SeuMscGzy/Anticipatory-Active-Inference-for-Visual-Servo-of-UAV/vrpn_client_ros/Ros环境下安装vrpn-client.pdf

# Ros环境下安装vrpn-client

## Ros环境下安装vrpn-client

### 环境要求 安装步骤 1.拷贝文件至ros工作路径下解压 2.安装vrpn_client_ros 3.返回工作空间编译 4.编译完成后，需要更新.bash 5.运行代码 方式一 方式二 注意事项 6.查看接收到的数据 提示信息 异常情况 1.没有数据信息 示例代码 CPP 联系方式

# 环境要求

1.支持ROS Melodic Morenia以及 (http://wiki.ros.org/melodic/Installation)ROS Kinetic Kame（测试环境是Melodic。Kinetic之前的版本可 (http://wiki.ros.org/kinetic/Installation)

## 能不兼容）

# 安装步骤

# 1.拷贝文件至ros工作路径下解压

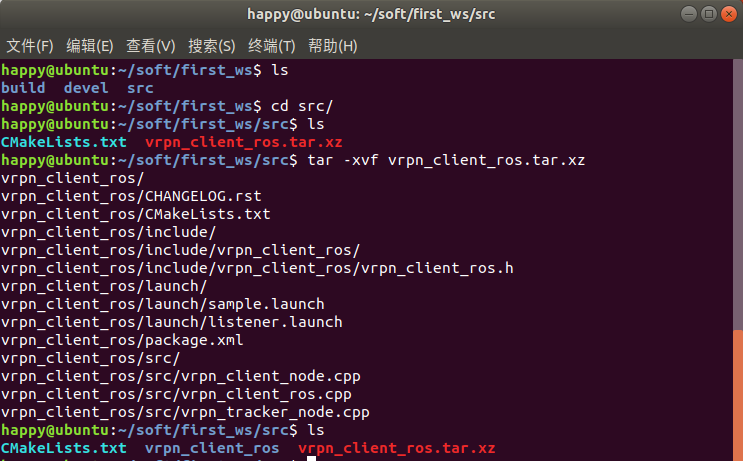
[picture p3: figure]

# 2.安装vrpn_client_ros

## kinetic下安装

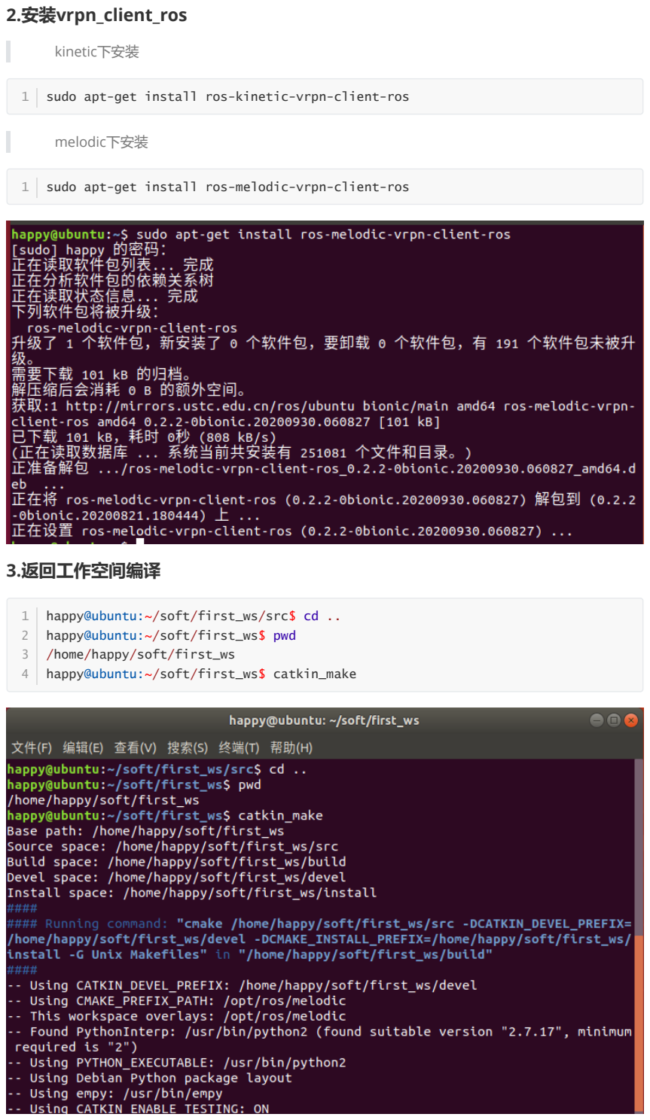
[picture p4: page 2]

## melodic下安装

# 3.返回工作空间编译

1 | sudo apt-get install ros-kinetic-vrpn-client-ros
1 | sudo apt-get install ros-melodic-vrpn-client-ros

happy@ubuntu:~/soft/first_ws/src$ cd .. happy@ubuntu:~/soft/first_ws$ pwd /home/happy/soft/first_ws
happy@ubuntu:~/soft/first_ws$ catkin_make

1
2
3
4

# 4.编译完成后，需要更新.bash

# 5.运行代码

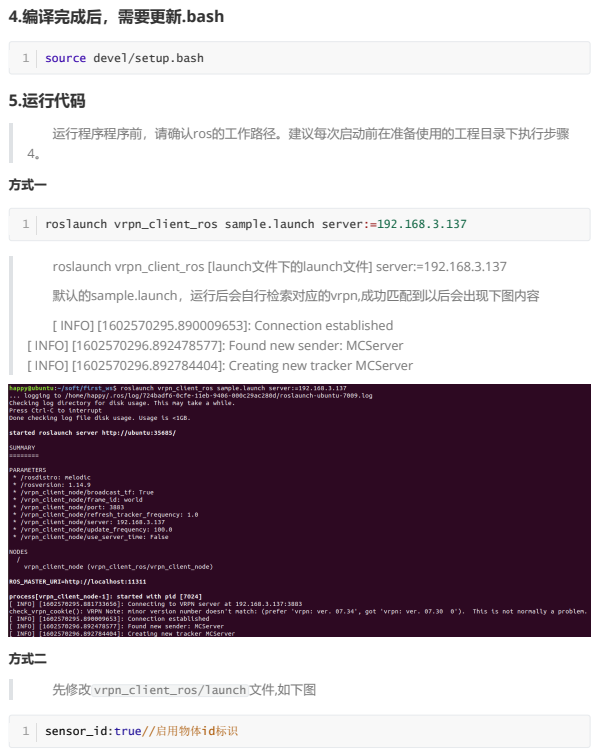
[picture p5: page 3]
运行程序程序前，请确认ros的工作路径。建议每次启动前在准备使用的工程目录下执行步骤; 方式一; 方式二; source devel/setup.bash; roslaunch vrpn_client_ros sample.launch server:=192.168.3.137; sensor_id:true//启用物体id标识

roslaunch vrpn_client_ros [launch文件下的launch文件] server:=192.168.3.137
默认的sample.launch，运行后会自行检索对应的vrpn,成功匹配到以后会出现下图内容
[ INFO] [1602570295.890009653]: Connection established
[ INFO] [1602570296.892478577]: Found new sender: MCServer
[ INFO] [1602570296.892784404]: Creating new tracker MCServer

先修改 vrpn_client_ros/launch 文件,如下图

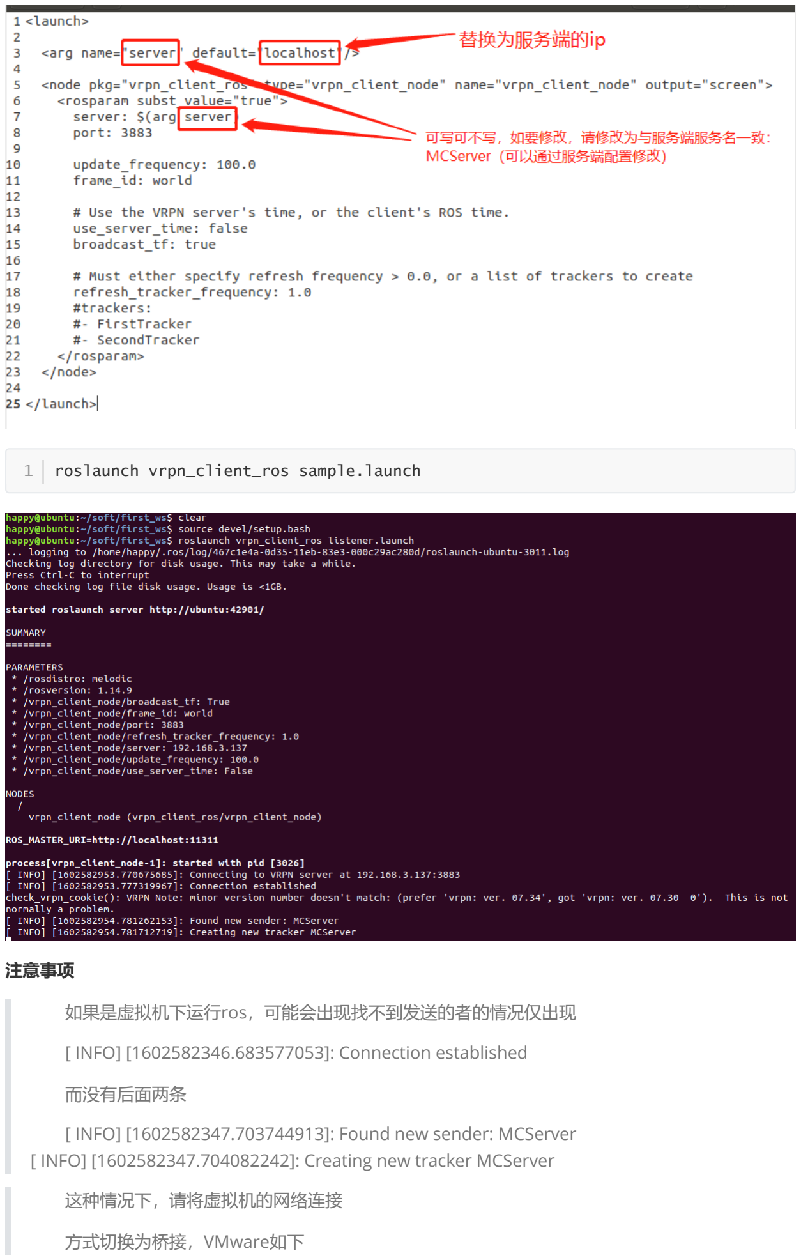
[picture p6: page 4]

## 注意事项

## 如果是虚拟机下运行ros，可能会出现找不到发送的者的情况仅出现

## [ INFO] [1602582346.683577053]: Connection established

## 而没有后面两条

## [ INFO] [1602582347.703744913]: Found new sender: MCServer [ INFO] [1602582347.704082242]: Creating new tracker MCServer

## 这种情况下，请将虚拟机的网络连接

## 方式切换为桥接，VMware如下

1 roslaunch vrpn_client_ros sample.launch

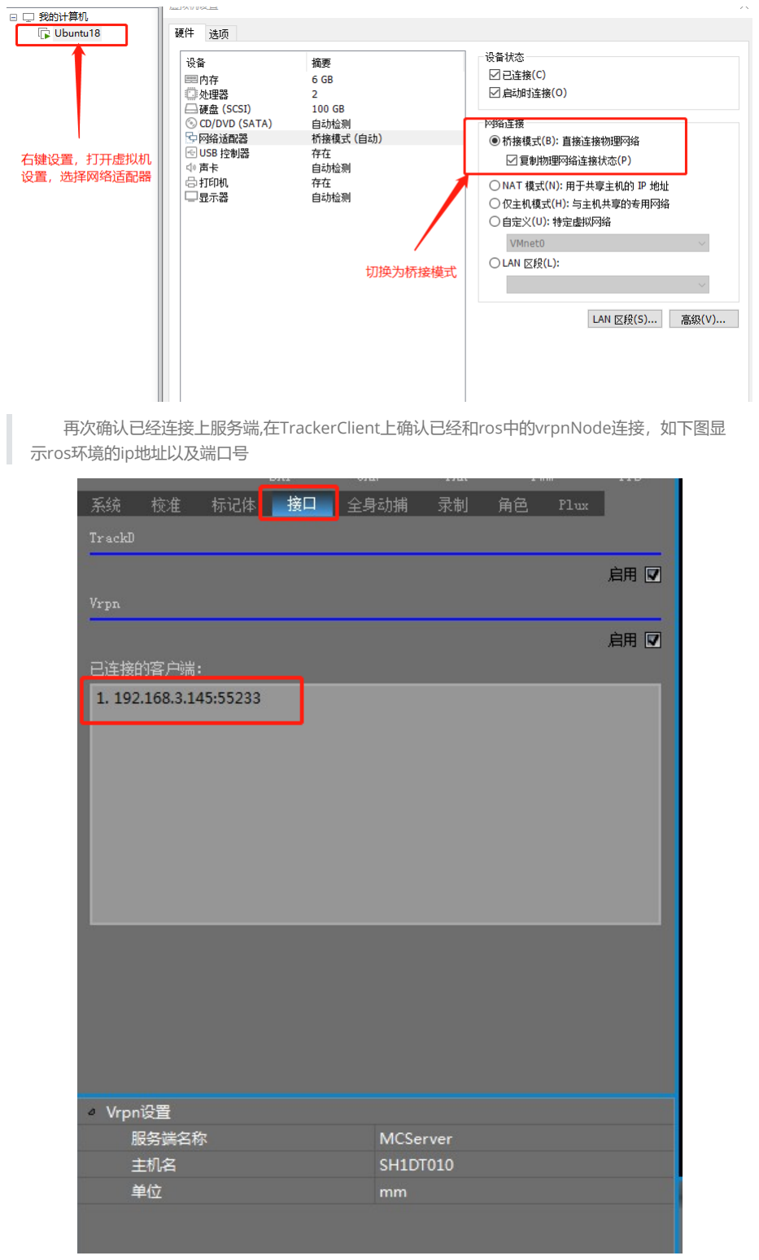
[picture p7: page 5]

## 再次确认已经连接上服务端,在TrackerClient上确认已经和ros中的vrpnNode连接，如下图显 示ros环境的ip地址以及端口号

# 6.查看接收到的数据

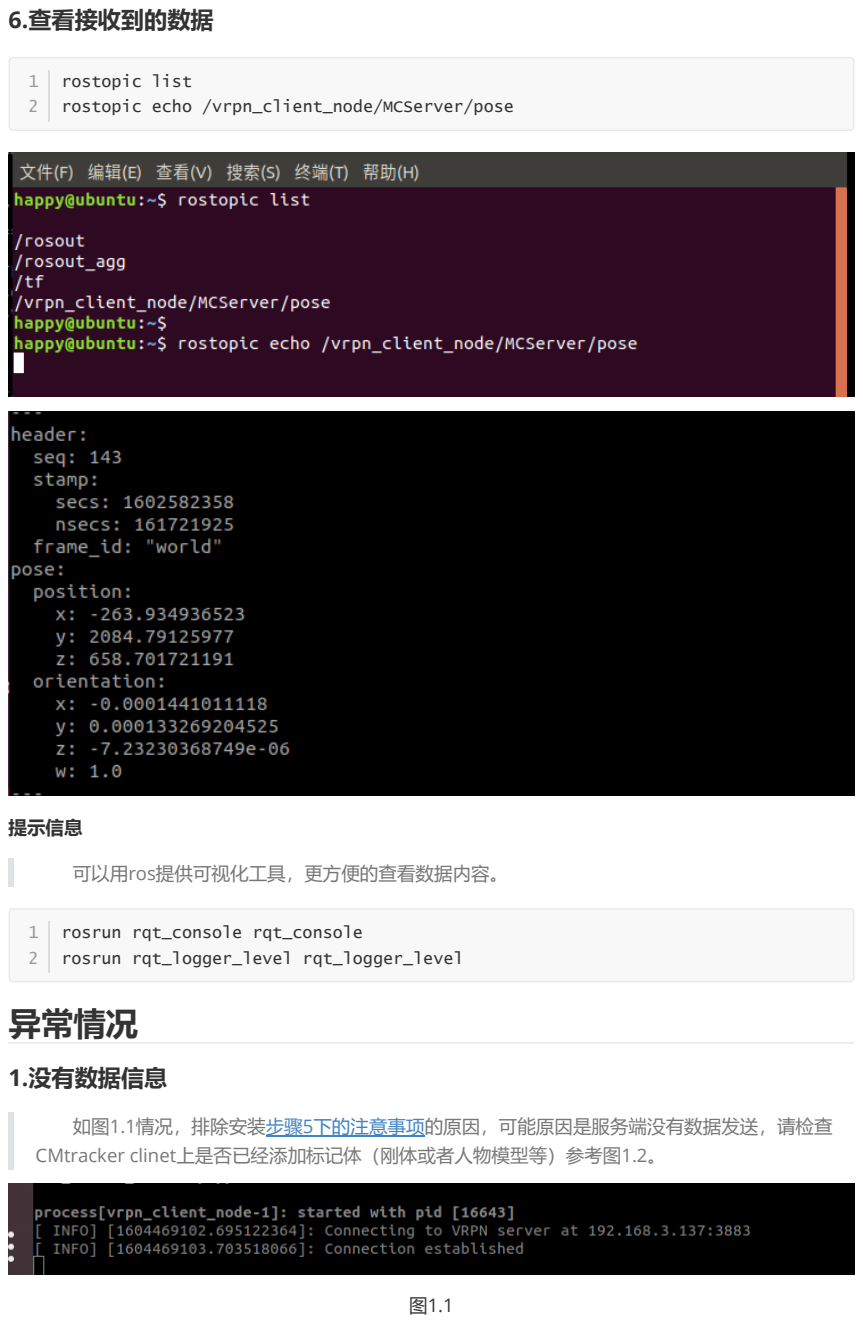
[picture p8: page 6]

图1.1

## 提示信息

## 可以用ros提供可视化工具，更方便的查看数据内容。

# 异常情况

# 1.没有数据信息

## 如图1.1情况，排除安装步骤5下的注意事项的原因，可能原因是服务端没有数据发送，请检查 CMtracker clinet上是否已经添加标记体（刚体或者人物模型等）参考图1.2。

rostopic list
rostopic echo /vrpn_client_node/MCServer/pose

1
2

rosrun rqt_console rqt_console
rosrun rqt_logger_level rqt_logger_level

1
2

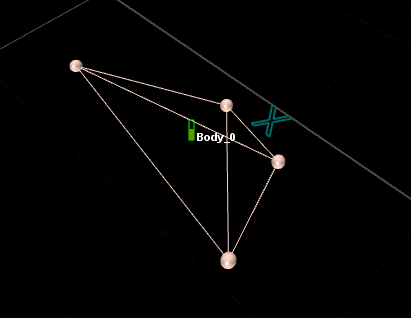
[picture p9: figure]

图1.2

# 示例代码

# CPP

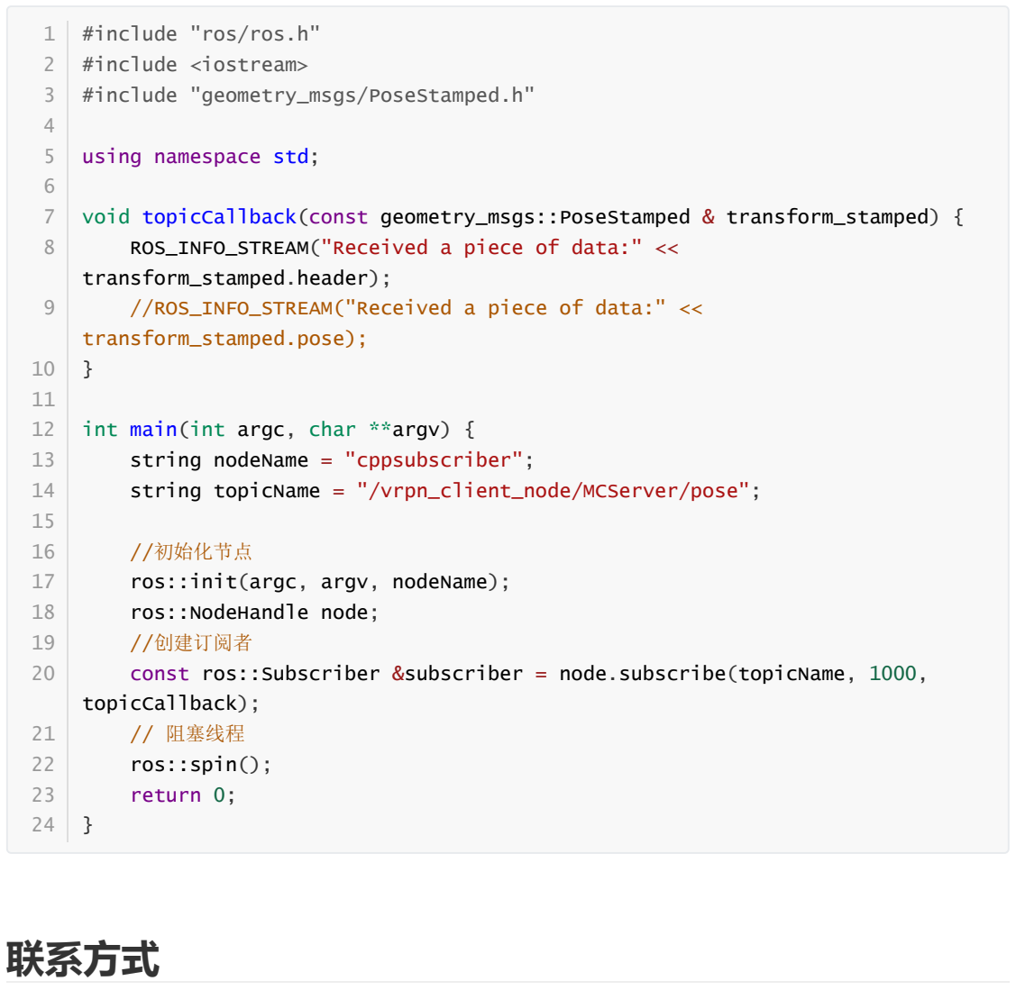
[picture p10: figure]
联系方式; #include "ros/ros.h"; #include <iostream>; #include "geometry_msgs/PoseStamped.h"; using namespace std;; transform_stamped.header);; transform_stamped.pose);; int main(int argc, char **argv) {; string nodeName = "cppsubscriber";; string topicName = "/vrpn_client_node/MCServer/pose";; //初始化节点; ros::init(argc, argv, nodeName);; ros::NodeHandle node; //创建订阅者; topicCallback); // 阻塞线程; ros::spin();; return 0;

void topicCallback(const geometry_msgs::PoseStamped & transform_stamped) { ROS_INFO_STREAM("Received a piece of data:" <<

//ROS_INFO_STREAM("Received a piece of data:" <<

const ros::Subscriber &subscriber = node.subscribe(topicName, 1000,

## 如果您安装的过程中遇到了其他疑问，欢迎致电青瞳视觉科技有限公司。

电话：021-56471565

## 技术支持：zhanghaidong@chingmu.com
