SeuMscGzy/Anticipatory-Active-Inference-for-Visual-Servo-of-UAV/platform_hardware/top plate.SLDPRT

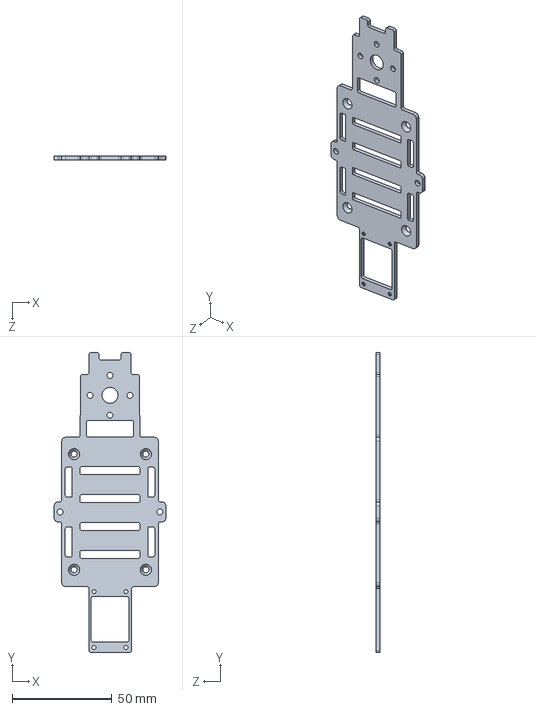
[picture p11: CAD file, 2026-01-14]
platform_hardware/top plate.SLDPRT
56.1 x 150.5 x 2.00 mm
