SeuMscGzy/Anticipatory-Active-Inference-for-Visual-Servo-of-UAV/platform_hardware/upboard for extra devices.SLDPRT

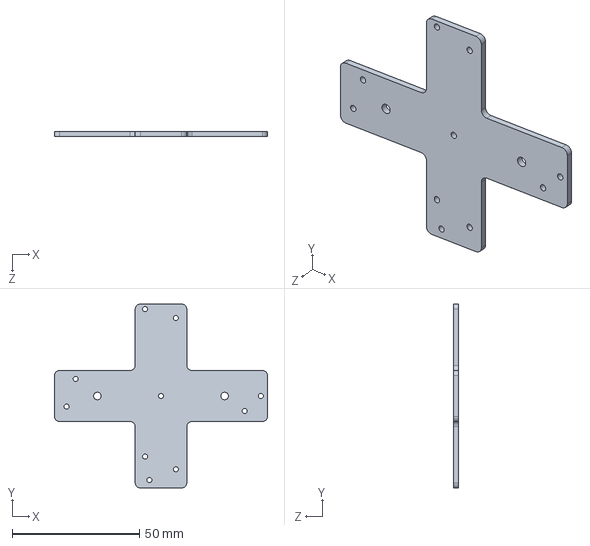
[picture p12: CAD file, 2026-01-14]
platform_hardware/upboard for extra devices.SLDPRT
83.7 x 72.3 x 2.00 mm
