SeuMscGzy/Anticipatory-Active-Inference-for-Visual-Servo-of-UAV/platform_hardware/baseborad.SLDPRT

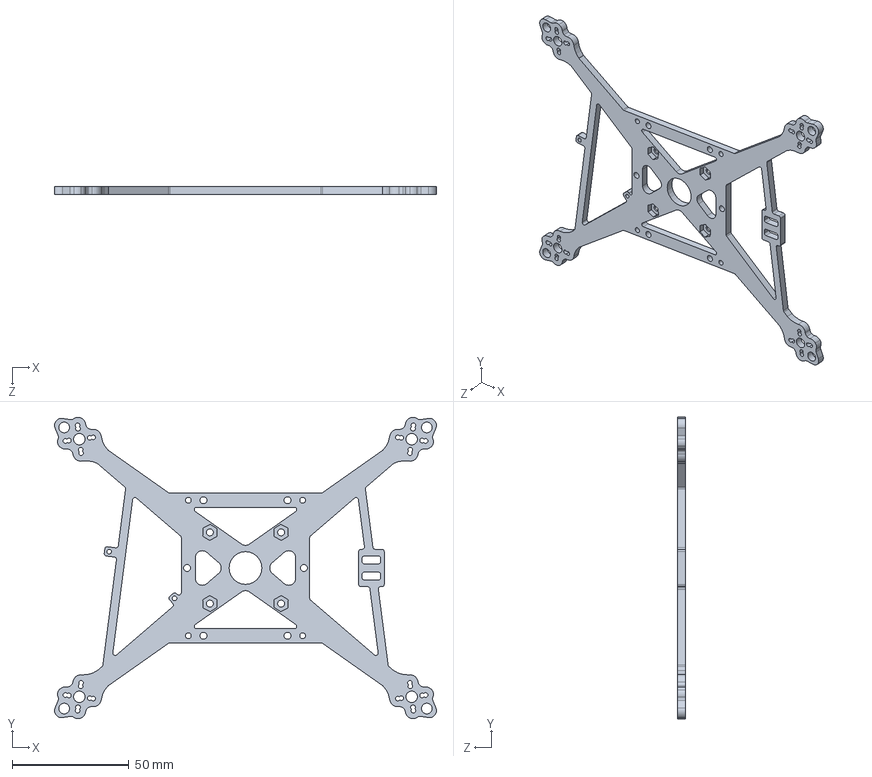
[picture p14: CAD file, 2026-01-14]
platform_hardware/baseborad.SLDPRT
163.5 x 129.1 x 3.50 mm
