SeuMscGzy/Anticipatory-Active-Inference-for-Visual-Servo-of-UAV/platform_hardware/tripod.SLDPRT

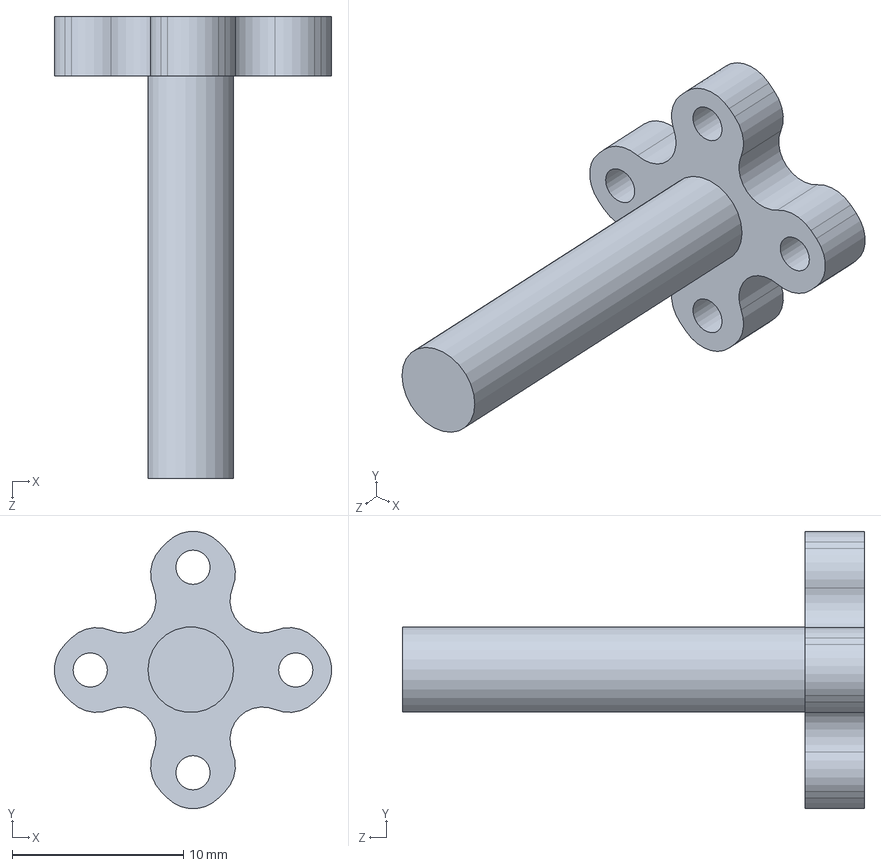
[picture p15: CAD file, 2026-01-14]
platform_hardware/tripod.SLDPRT
16.2 x 16.2 x 27.0 mm
