SeuMscGzy/Anticipatory-Active-Inference-for-Visual-Servo-of-UAV/transfer_aai_to_qp_problem.pdf

# Formulation of Prospective Active Inference as Quadratic Programming

## 1 Problem Statement

Consider the discrete-time Linear Time-Invariant (LTI) dynamical system model described by:

xk+1 = Axk + Buk + Fwk, | (1)
yk = Cxk + vk, | (2)

where xk ∈ R

n
represents the system state, uk ∈ R
m is the control input, and yk ∈ R | p is
the observation output.
In the active inference framework, we introduce a generative model to encapsulate the dynamics of the internal state. Let zk denote the internal state, which evolves according to the internal model:
zi+1|k = (A + BK)zi|k + wi|k, | (3)

where i denotes the prediction step index relative to the current time step k.

## 2 Future Variational Free Energy (F-VFE) Objective

At time step k, considering a prediction horizon N, we define the cumulative Variational Free Energy, denoted as Fk. This objective function is composed of two primary compo-nents: the external state error (deviation between the predicted system state x and the internal state z) and the internal dynamic consistency error:

Fk =

1
2

X

N

i=1

xi|k − zi|k

2

R˜
| | {z | }
State/Observation Error

+

1
2

X

N

i=1

zi|k − (A + BK)zi−1|k

2

Q˜
| | {z | }
| Internal Dynamics Consistency
. | (4)

## 3 Compact Matrix Formulation

To formulate the optimization problem as a standard Quadratic Program (QP), we define the lifted vectors over the horizon N:

Xk =

x1|k

xN|k

, Zk =

z1|k

zN|k

, Uk =

u0|k

uN−1|k

. | (5)

1

Based on the system dynamics (1), the predicted state trajectory Xk can be expressed as an affine function of the initial state and future control inputs:

| Xk = Fxk + ΦUk, | (6)

where F and Φ are the standard prediction matrices derived from (A, B).
To capture the internal state dynamics (3), we define the shift matrix S and the block-diagonal dynamics matrix M:
S = IN×N , | M = blockdiag(A + BK, . . . , A + BK). | (7)

The cost function (4) can then be rewritten in a compact quadratic form:

Fk =

1
2

∥Xk − Zk∥

| 2
| R˜ +
| 1
| 2

∥(S − M)Zk∥

| 2
| Q˜ . | (8)

## 4 Transformation to Standard QP Form

We define the joint optimization variable ξ(k) containing both control inputs and internal states:
ξ(k) = "
| Uk
| Zk
| . | (9)

We introduce transformation matrices T1 and T2 to express the error terms with respect to ξ(k):
| T1 =

h
| Φ −I

i
, T2 =

h
| 0 I

i
| . | (10)

Substituting Xk = Fxk + ΦUk into the cost function terms yields:

Xk − Zk = Fxk + ΦUk − Zk = Fxk + T1ξ(k), | (11)
(S − M)Zk = (S − M)T2ξ(k). | (12)

Expanding the cost function Fk(ξ), we obtain the standard quadratic form used for optimization:

| min
| ξ
| 1
| 2 ξ THξ + g T
| ξ, | (13)

where the Hessian matrix H and gradient vector g are given by:

H = T | T

1 RT˜
1 + T

T
2

(S − M)

TQ˜(S − M)T2, | (14)

g = T

T

1 R˜Fxk. | (15)

This formulation allows the Prospective Active Inference problem to be solved efficiently using standard QP solvers (e.g., qpOASES, OSQP), optimizing simultaneously for the control actions Uk and the internal state trajectory Zk.

2
