SeuMscGzy/Anticipatory-Active-Inference-for-Visual-Servo-of-UAV/Anticipatory_Active_Inference_with_Data_Augmentation/src/aai_qp.cpp

#include "aai_qp.h"

Optimizer::Optimizer(double dt, int Np, double precice_z1, double precice_z2,
                     double precice_w1, double precice_w2, double precice_z_u, double e1,
                     double umin, double umax)
    : dt(dt), Np(Np), precice_z1(precice_z1), precice_z2(precice_z2),
      precice_w1(precice_w1), precice_w2(precice_w2), precice_z_u(precice_z_u), e1(e1),
      umin(umin), umax(umax)
{
    // 离散系统矩阵
    MatrixXd Ad(6, 6);
    Ad << 1, 0, 0, dt, 0, 0,
        0, 1, 0, 0, dt, 0,
        0, 0, 1, 0, 0, dt,
        0, 0, 0, 1, 0, 0,
        0, 0, 0, 0, 1, 0,
        0, 0, 0, 0, 0, 1;
    MatrixXd Bd(6, 3);
    Bd << -0.5 * dt * dt, 0, 0,
        0, -0.5 * dt * dt, 0,
        0, 0, -0.5 * dt * dt,
        -dt, 0, 0,
        0, -dt, 0,
        0, 0, -dt;
    Eigen::MatrixXd K(6, 6);
    K << 0.8, 0, 0, 0, 0, 0,
        0, 0.8, 0, 0, 0, 0,
        0, 0, 0.8, 0, 0, 0,
        0, 0, 0, 0.15, 0, 0,
        0, 0, 0, 0, 0.15, 0,
        0, 0, 0, 0, 0, 0.15;
    Eigen::MatrixXd Closed_A = Ad - K;
    Eigen::VectorXd zr(6);
    zr << 0, 0, 0, 0, 0, 0;
    Eigen::VectorXd kr = K * zr;
    Eigen::VectorXd kr_temp = Eigen::VectorXd::Ones(Np);
    Eigen::MatrixXd kr_full = kroneckerProduct(kr_temp, kr);

    MatrixXd S_temp = MatrixXd::Zero(Np, Np + 1);
    for (int i = 0; i < Np; ++i)
    {
        S_temp(i, i + 1) = 1;
    }

    // Define 2x2 identity matrix I2
    MatrixXd I2 = MatrixXd::Identity(6, 6);

    // Compute Kronecker product S = S_temp ⊗ I2
    MatrixXd S = kroneckerProduct(S_temp, I2);

    // Define Np x (Np + 1) matrix M_temp
    MatrixXd M_temp = MatrixXd::Zero(Np, Np + 1);
    for (int i = 0; i < Np; ++i)
    {
        M_temp(i, i) = 1;
    }

    // Compute Kronecker product M = M_temp ⊗ Closed_A
    MatrixXd M = kroneckerProduct(M_temp, Closed_A);

    // Compute F
    Eigen::MatrixXd F = Eigen::MatrixXd::Identity(6, 6);
    Eigen::MatrixXd F_temp = Ad;
    for (int i = 1; i <= Np; ++i)
    {
        // Stack F_temp below F
        Eigen::MatrixXd F_new(F.rows() + F_temp.rows(), F.cols());
        F_new << F, F_temp;
        F = F_new;
        // Update F_temp to the next power of Ad
        F_temp = F_temp * Ad;
    }

    // Initialize Phi matrix
    Eigen::MatrixXd Phi((Np + 1) * 6, 3 * Np);
    Phi.setZero(); // Set all elements to zero
    // Construct Phi matrix
    for (int i = 2; i <= Np + 1; ++i)
    {
        for (int j = 1; j < i; ++j)
        {
            int power = i - j - 1;

            // Compute A to the power of 'power'
            Eigen::MatrixXd A_power = Eigen::MatrixXd::Identity(6, 6);
            for (int p = 0; p < power; ++p)
            {
                A_power *= Ad;
            }

            // Compute block = A_power * Bd
            Eigen::MatrixXd block = A_power * Bd;

            // Determine the position in Phi
            int row_start = (i - 1) * 6;
            int col_start = 3 * (j - 1);

            // Place block into Phi
            Phi.block(row_start, col_start, 6, 3) = block;
        }
    }

    // Compute T1 and T2
    Eigen::MatrixXd T11((6 * Np + 6), (6 * Np + 6));
    T11.setZero();
    // Fill T11 with identity matrices along the diagonal
    for (int i = 0; i <= Np; ++i)
    {
        T11.block(6 * i, 6 * i, 6, 6) = Eigen::MatrixXd::Identity(6, 6);
    }
    MatrixXd T1(Phi.rows(), Phi.cols() + T11.cols());
    T1 << Phi, -T11;

    // Initialize and construct T2
    Eigen::MatrixXd T2_temp1 = Eigen::MatrixXd::Zero(6 * (Np + 1), 3 * Np);
    Eigen::MatrixXd T2_temp2 = Eigen::MatrixXd::Identity(6 * (Np + 1), 6 * (Np + 1));
    Eigen::MatrixXd T2(T2_temp1.rows(), T2_temp1.cols() + T2_temp2.cols());
    T2 << T2_temp1, T2_temp2;

    // Initialize and construct T3
    Eigen::MatrixXd T3_temp1 = Eigen::MatrixXd::Identity(3 * Np, 3 * Np);
    Eigen::MatrixXd T3_temp2 = Eigen::MatrixXd::Zero(3 * Np, 6 * (Np + 1));
    Eigen::MatrixXd T3(T3_temp1.rows(), T3_temp1.cols() + T3_temp2.cols());
    T3 << T3_temp1, T3_temp2;

    // Compute BigB
    MatrixXd BigB = kroneckerProduct(MatrixXd::Identity(Np, Np), Bd);

    Eigen::MatrixXd R(6, 6);
    R.setZero();
    R(0, 0) = precice_z1;
    R(1, 1) = precice_z1;
    R(2, 2) = precice_z1;
    R(3, 3) = precice_z2;
    R(4, 4) = precice_z2;
    R(5, 5) = precice_z2;
    Eigen::MatrixXd C = Eigen::MatrixXd::Identity(6, 6);
    R = C.transpose() * R * C;

    // Initialize bigR matrix
    Eigen::MatrixXd bigR(6 * (Np + 1), 6 * (Np + 1));
    bigR.setZero();
    for (int i = 0; i <= Np; ++i)
    {
        bigR.block(6 * i, 6 * i, 6, 6) = R;
    }

    // Initialize Q matrix
    Eigen::MatrixXd Q(6, 6);
    Q.setZero();
    Q(0, 0) = precice_w1;
    Q(1, 1) = precice_w1;
    Q(2, 2) = precice_w1;
    Q(3, 3) = precice_w2;
    Q(4, 4) = precice_w2;
    Q(5, 5) = precice_w2;

    // Initialize bigQ matrix
    Eigen::MatrixXd bigQ(6 * Np, 6 * Np);
    bigQ.setZero();
    for (int i = 0; i < Np; ++i)
    {
        bigQ.block(6 * i, 6 * i, 6, 6) = Q;
    }

    Eigen::MatrixXd S_M = S - M;

    // Compute T4 = S_M * T2 - BigB * T3
    MatrixXd T4 = S_M * T2 - BigB * T3;

    // Compute bigMatrix1 = T1' * bigR * T1 + T4' * bigQ * T4
    bigMatrix1 = T1.transpose() * bigR * T1 + T4.transpose() * bigQ * T4;

    // Define M13 = zeros(Np + 2 * (Np + 1), Np + 2 * (Np + 1))
    MatrixXd M13 = MatrixXd::Zero(3 * Np + 6 * (Np + 1), 3 * Np + 6 * (Np + 1));

    // Set M13(0:Np - 1, 0:Np - 1) = Identity matrix
    M13.block(0, 0, 3 * Np, 3 * Np) = MatrixXd::Identity(3 * Np, 3 * Np);

    // Update bigMatrix1
    bigMatrix1 += M13 * precice_z_u;
    cout << bigMatrix1 << endl;
    /*// Compute eigenvalues of bigMatrix1
    SelfAdjointEigenSolver<MatrixXd> eigensolver(bigMatrix1);
    if (eigensolver.info() != Success)
    {
        std::cerr << "Eigenvalue computation did not converge." << std::endl;
    }
    VectorXd eigenvalues = eigensolver.eigenvalues();*/

    bigMatrix2 = F.transpose() * bigR * T1;

    // Compute bigMatrix3 = -kr' * bigQ * T4
    bigMatrix3 = -kr_full.transpose() * bigQ * T4;
    //cout << bigMatrix3 << endl;
    /*
    // 构建矩阵 M1 到 M4
    MatrixXd M1(1, 4);
    M1 << 0, 0, e1, 1;
    //cout << M1 << endl;
    MatrixXd M2(1, 4);
    M2 << 1, 0, -1, 0;

    MatrixXd M3(1, 4);
    M3 << 0, 0, 0, e1;
    //cout << M3 << endl;
    MatrixXd M4(1, 4);
    M4 << 0, 1, 0, -1;

    MatrixXd M5(4, 4);
    M5 = 0.5 * precice_w1 * M1.transpose() * M1 + 0.5 * precice_z1 * M2.transpose() * M2 + 0.5 * precice_w2 * M3.transpose() * M3 + 0.5 * precice_z2 * M4.transpose() * M4;
    //cout << M5 << endl;

    MatrixXd M6 = kroneckerProduct(MatrixXd::Identity(Np + 1, Np + 1), M5);

    int s = 2;
    int num_block_rows = 2 * Np + 2;
    int num_block_cols = 2 * Np + 2;

    MatrixXd M7 = MatrixXd::Zero(s * num_block_rows, s * num_block_cols);
    MatrixXd I = MatrixXd::Identity(s, s);

    // 奇数块
    for (int i_block = 1; i_block <= 2 * Np + 1; i_block += 2)
    {
        int j_block = (i_block + 1) / 2;
        int row_start = (i_block - 1) * s;
        int col_start = (j_block - 1) * s;
        M7.block(row_start, col_start, s, s) = I;
    }

    // 偶数块
    for (int i_block = 2; i_block <= 2 * Np + 2; i_block += 2)
    {
        int j_block = Np + (i_block + 2) / 2;
        int row_start = (i_block - 1) * s;
        int col_start = (j_block - 1) * s;
        M7.block(row_start, col_start, s, s) = I;
    }

    MatrixXd F = MatrixXd::Identity(2, 2);
    MatrixXd F_temp = Ad;
    for (int i = 1; i <= Np; ++i)
    {
        F.conservativeResize(F.rows() + 2, F.cols());
        F.block(2 * i, 0, 2, 2) = F_temp;
        F_temp *= Ad;
    }
    // cout << F << endl;
    //   初始化 Phi 矩阵
    MatrixXd Phi((Np + 1) * 2, Np);
    Phi.setZero();
    // 构建 Phi 矩阵
    for (int i = 2; i <= Np + 1; ++i)
    {
        for (int j = 1; j < i; ++j)
        {
            int power = i - j - 1;

            // 计算 A 的幂
            MatrixXd A_power = MatrixXd::Identity(2, 2); // 初始化为单位矩阵
            for (int p = 1; p <= power; ++p)
            {
                A_power *= Ad;
            }

            // 计算块
            MatrixXd block = A_power * Bd;

            // 确定在 Phi 中的位置
            int row_start = (i - 1) * 2;
            int col_start = (j - 1);

            // 将块放入 Phi
            Phi.block(row_start, col_start, 2, 1) = block;
        }
    }
    // cout << Phi << endl;
    MatrixXd T2 = MatrixXd::Identity((Np + 1) * 2, (Np + 1) * 2);
    MatrixXd T1(Phi.rows(), Phi.cols() + T2.cols());
    T1 << Phi, -T2;
    MatrixXd M8 = MatrixXd::Zero(2 * (Np + 1) * 2, Np + 2 * (Np + 1));
    M8.block(0, 0, 2 * (Np + 1), Np) = Phi;
    M8.block(2 * (Np + 1), Np, 2 * (Np + 1), 2 * (Np + 1)) = MatrixXd::Identity(2 * (Np + 1), 2 * (Np + 1));

    MatrixXd M9 = MatrixXd::Zero(Np + 2 * (Np + 1), Np + 2 * (Np + 1));
    M9.block(0, 0, Np, Np) = MatrixXd::Identity(Np, Np);
    bigMatrix1 = 2 * M8.transpose() * M7.transpose() * M6 * M7 * M8 + M9 * precice_z_u;
    //cout << bigMatrix1 << endl;
    //  Compute bigMatrix2 using Eigen
    MatrixXd R = MatrixXd::Zero(2, 2);
    R(0, 0) = precice_z1;
    R(1, 1) = precice_z2;
    MatrixXd bigR = MatrixXd::Zero(2 * (Np + 1), 2 * (Np + 1));
    for (int i = 0; i < Np + 1; ++i)
    {
        bigR.block(2 * i, 2 * i, 2, 2) = R;
    }
    MatrixXd bigMatrix2_ = F.transpose() * bigR * T1;
    // cout << bigMatrix2_ << endl;
    bigMatrix2 = bigMatrix2_;*/

    // Initialize the solver matrices
    initsolver();
    cout << "Optimizer initialized" << endl;
}

void Optimizer::shiftDecisionVariables(VectorXd &solution, VectorXd &Dualsolution)
{
    // 左移 solution 和 Dualsolution 的前 Np - 1 个元素
    if (Np > 1)
    {
        solution.head(3 * (Np - 1)) = solution.segment(3, 3 * Np - 3);
        Dualsolution.head(3 * (Np - 1)) = Dualsolution.segment(3, 3 * Np - 3);

        // 将倒数第二个元素复制到最后一个位置
        solution(3 * Np - 3) = solution(3 * Np - 6);
        solution(3 * Np - 2) = solution(3 * Np - 5);
        solution(3 * Np - 1) = solution(3 * Np - 4);
        Dualsolution(3 * Np - 3) = Dualsolution(3 * Np - 6);
        Dualsolution(3 * Np - 2) = Dualsolution(3 * Np - 5);
        Dualsolution(3 * Np - 1) = Dualsolution(3 * Np - 4);

        // 计算 solution 向量的总长度
        int totalSize = solution.size();

        // 计算剩余部分的长度
        int remaining = totalSize - 3 * Np;

        // 左移 solution 的剩余部分
        solution.segment(3 * Np, remaining - 6) = solution.segment(3 * Np + 6, remaining - 6);

        solution(totalSize - 6) = solution(totalSize - 12);
        solution(totalSize - 5) = solution(totalSize - 11);
        solution(totalSize - 4) = solution(totalSize - 10);
        solution(totalSize - 3) = solution(totalSize - 9);
        solution(totalSize - 2) = solution(totalSize - 8);
        solution(totalSize - 1) = solution(totalSize - 7);
    }
    else
    {
        return;
    }
}

vector<double> Optimizer::optimize(Eigen::Vector3d x, Eigen::Vector3d vx, Eigen::Vector3d mu_init_, Eigen::Vector3d mu_p_init_)
{
    RowVectorXd rowVec(6);
    rowVec << x, vx;
    q = rowVec * bigMatrix2 + bigMatrix3;
    // cout << q << endl;
    l[3 * Np] = mu_init_[0] - 0.1;
    u[3 * Np] = mu_init_[0] + 0.1;
    l[3 * Np + 1] = mu_init_[1] - 0.1;
    u[3 * Np + 1] = mu_init_[1] + 0.1;
    l[3 * Np + 2] = mu_init_[2] - 0.1;
    u[3 * Np + 2] = mu_init_[2] + 0.1;
    l[3 * Np + 3] = mu_p_init_[0] - 0.1;
    u[3 * Np + 3] = mu_p_init_[0] + 0.1;
    l[3 * Np + 4] = mu_p_init_[1] - 0.1;
    u[3 * Np + 4] = mu_p_init_[1] + 0.1;
    l[3 * Np + 5] = mu_p_init_[2] - 0.1;
    u[3 * Np + 5] = mu_p_init_[2] + 0.1;
    // cout << q << endl;
    // 更新求解器的梯度和边界
    solver.updateGradient(q);
    solver.updateLowerBound(l);
    solver.updateUpperBound(u);

    // 在更新求解器的梯度和边界之前，打印 l 和 u
    // std::cout << "l: " << l.transpose() << std::endl;
    // std::cout << "u: " << u.transpose() << std::endl;

    // 求解更新后的问题
    auto sol_result = solver.solveProblem();
    if (sol_result == OsqpEigen::ErrorExitFlag::NoError)
    {
        VectorXd solution = solver.getSolution();
        // cout << "solution: " << solution << endl;
        VectorXd Dualsolution = solver.getDualSolution();

        // Extracting u which has Np elements
        double ux_now = solution(0);
        double uy_now = solution(1);
        double uz_now = solution(2);

        // Extracting mu which has Np + 1 elements
        double mu_x_next = solution(3 * Np + 6);
        double mu_y_next = solution(3 * Np + 7);
        double mu_z_next = solution(3 * Np + 8);

        // Extracting mu_p which also has Np + 1 elements
        double mu_p_x_next = solution(3 * Np + 9);
        double mu_p_y_next = solution(3 * Np + 10);
        double mu_p_z_next = solution(3 * Np + 11);

        // 计算总代价
        double cost = solver.getObjValue();

        shiftDecisionVariables(solution, Dualsolution);

        solver.setWarmStart(solution, Dualsolution);

        vector<double> result = {ux_now, uy_now, uz_now, mu_x_next, mu_y_next, mu_z_next, mu_p_x_next, mu_p_y_next, mu_p_z_next, cost};
        return result;
    }
    else
    {
        std::cerr << "Failed to solve the problem" << std::endl;
        vector<double> result = {0, 0, 0, 0, 0, 0, 0, 0, 0, 0};
        return result;
    }
}

void Optimizer::initsolver()
{
    // 初始化求解器
    solver.data()->setNumberOfVariables(3 * Np + 6 * (Np + 1));
    solver.data()->setNumberOfConstraints(3 * Np + 6);
    solver.settings()->setAbsoluteTolerance(1e-3); // 设置绝对误差阈值
    solver.settings()->setRelativeTolerance(1e-3); // 设置相对误差阈值
    solver.settings()->setMaxIteration(100);       // 设置最大迭代次数为100
    solver.settings()->setVerbosity(false);
    P = bigMatrix1.sparseView();
    // cout << P << endl;
    VectorXd q1(3 * Np + 6 * (Np + 1));
    q = q1;

    SparseMatrix<double> A1(3 * Np + 6, 3 * Np + 6 * (Np + 1));
    // 创建一个容器来存储非零元素
    std::vector<Triplet<double>> triplets;

    // 构造 A 矩阵
    for (int i = 0; i < 3 * Np + 6; ++i)
    {
        // 在第 i 行，第 i 列设置值为 1
        triplets.emplace_back(i, i, 1.0);
    }
    // 将非零元素添加到 A 矩阵
    A1.setFromTriplets(triplets.begin(), triplets.end());
    A = A1;
    VectorXd l1(3 * Np + 6), u1(3 * Np + 6);
    l = l1;
    u = u1;
    // 设置上下界
    l.head(3 * Np).setConstant(umin);
    u.head(3 * Np).setConstant(umax);

    // 设置额外变量的精确值
    l[3 * Np] = 0;
    u[3 * Np] = 0;
    l[3 * Np + 1] = 0;
    u[3 * Np + 1] = 0;
    l[3 * Np + 2] = 0;
    u[3 * Np + 2] = 0;
    l[3 * Np + 3] = 0;
    u[3 * Np + 3] = 0;
    l[3 * Np + 4] = 0;
    u[3 * Np + 4] = 0;
    l[3 * Np + 5] = 0;
    u[3 * Np + 5] = 0;
    // cout << l << endl;
    // cout << u << endl;
    // solver.data()->setNumberOfVariables(Np + 2 * (Np + 1));
    // solver.data()->setNumberOfConstraints(Np + 2 * (Np + 1));
    //  配置求解器
    if (!solver.data()->setHessianMatrix(P) ||
        !solver.data()->setGradient(q) ||
        !solver.data()->setLinearConstraintsMatrix(A) ||
        !solver.data()->setLowerBound(l) ||
        !solver.data()->setUpperBound(u))
    {
        std::cerr << "Problem setting solver data!" << std::endl;
        return; // 或其他错误处理
    }
    solver.initSolver();
}
