SeuMscGzy/Anticipatory-Active-Inference-for-Visual-Servo-of-UAV/(commit log)

2024-10-28 use multi thread to isolate image recieve and calculation: bug may exists!
2024-10-29 use atomic to avoid write and read faults in multi thread scheme
2024-11-08 APO test: need to find how to obtain the real position and velocity of the apriltag to help tune APO
2024-11-10 use multi-thread instead of three ros nodes
2024-11-16 update the relationship between imu and cam after calibration using kalibr
2024-12-17 avoid integral saturation in slow start state when the thrust2acc parameter is not suitable
2025-03-08 bug fix for RSM
    [data.csv]
2025-03-11 parameter tuning for RSM
    [data.csv]
2025-03-12 big bug fix for RSM
    [data.csv]
2025-03-13 change visp to apriltag3
    [data.csv]
2025-03-14 bug fix and small improvements
    [Relative_Pos_Cal_apriltag.cpp]
2025-03-14 try qpOASES but failed, as it is worse than OSQP
    [data.csv]
2025-03-25 bug fix for yaw calculation in world frame of apriltag
    [data.csv]
2025-03-28 bug fix for relative pos cal
    [Relative_Pos_Cal_apriltag.cpp]
2025-05-25 bug fix
    [data.csv]
2025-05-27 use visp to cal relative pos
    [data.csv]
2025-05-27 bug fix for yaw calculation
    [Relative_Pos_Cal_apriltag.cpp, Relative_Pos_Cal_apriltag.h]
2025-05-28 available for RealSensed d405 camera
2025-05-29 bug fix for px4ctrl
    [ctrl_param_fpv.yaml]
2025-05-29 improve take off and landing detection
2025-11-27 bug fix for Relative_pos_cal
    [Relative_Pos_Cal_apriltag.cpp]
2025-11-27 bug fix for Model_predictive_active_inference
    [data.csv]
2025-12-03 bug fix for Relative_Pos_Cal: yaw calculation
    [Relative_Pos_Cal_apriltag.cpp, Relative_Pos_Cal_apriltag.h]
2025-12-08 add ground truth of car for visualization
2026-01-14 success of anticipatory active inference in uav test
    [data.csv]
2026-01-14 Fix image link for Thrust Test Platform
    Updated image reference for Thrust Test Platform in README.
